Jinwoo290350/Hardware-Project/Flow-Hardware-Project.png

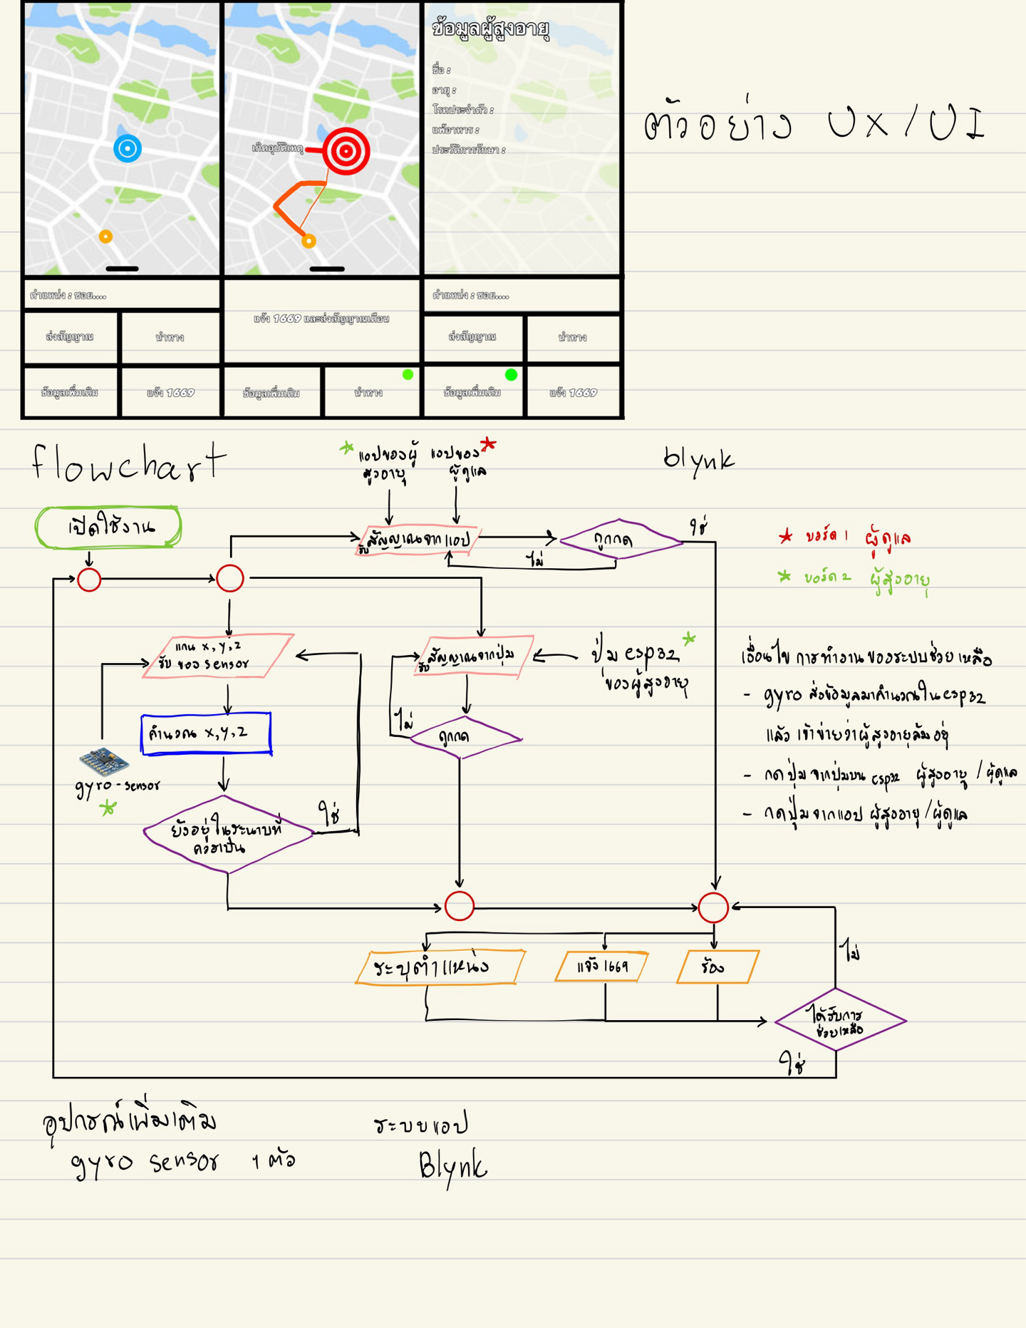
Flow-Hardware-Project.png
