Jinwoo290350/Hardware-Project/ML/models/CHEST_confusion.png

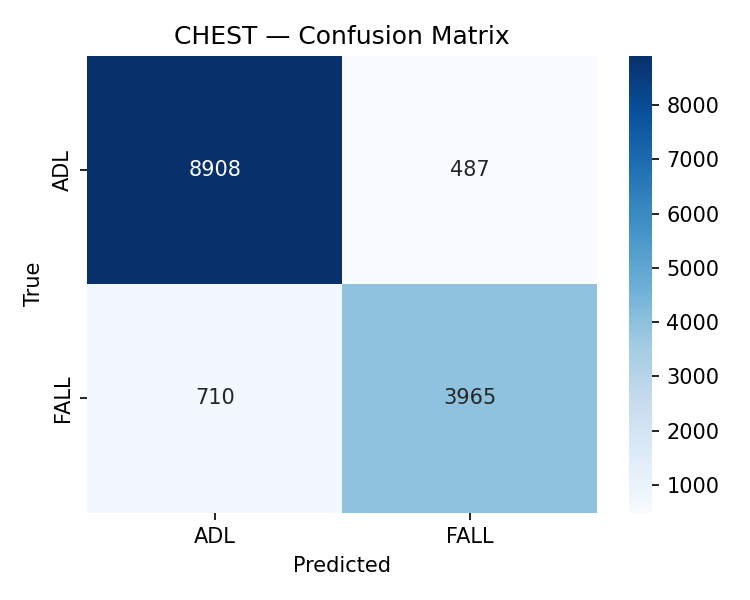
ML/models/CHEST_confusion.png
