Jinwoo290350/Hardware-Project/ML/models/CHEST_importance.png

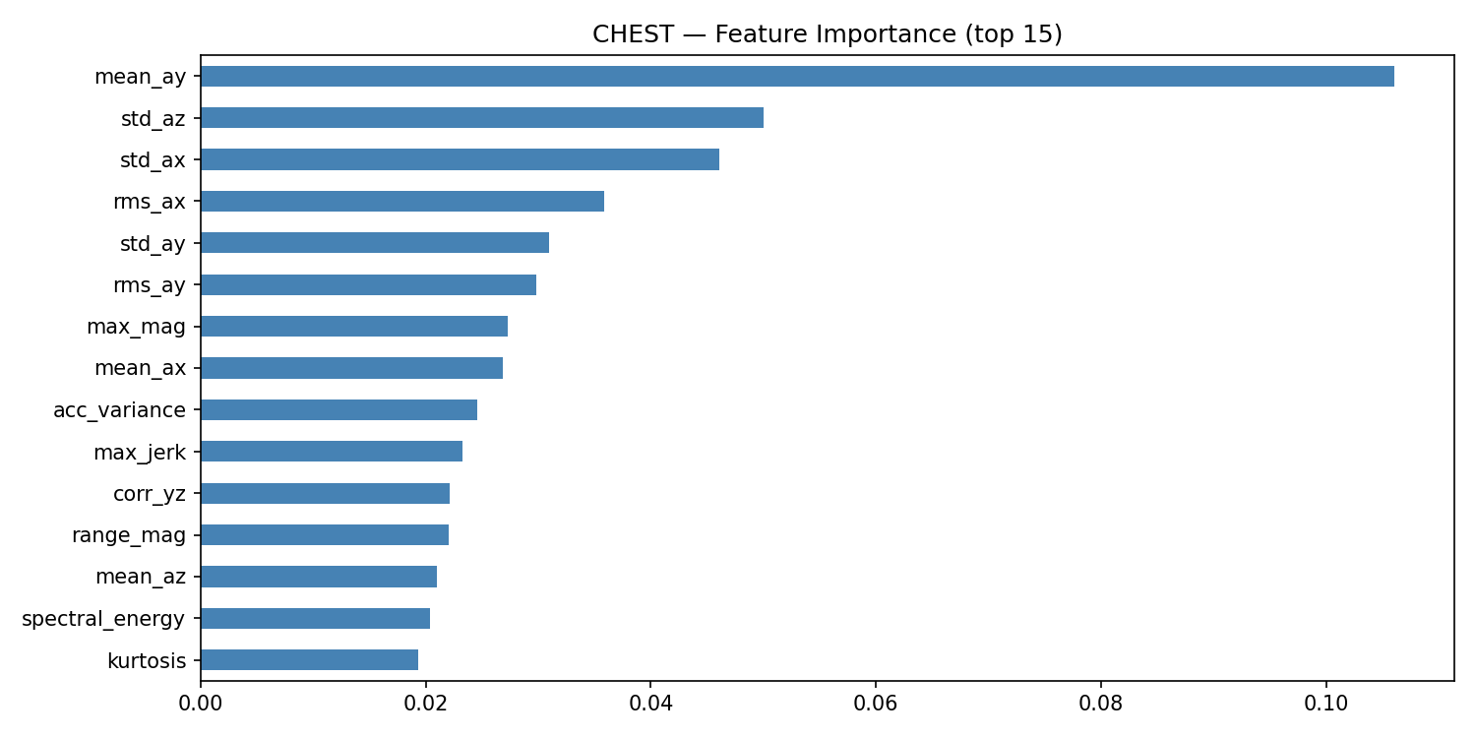
ML/models/CHEST_importance.png
