Jinwoo290350/Hardware-Project/ML/models/CHEST_signal.png

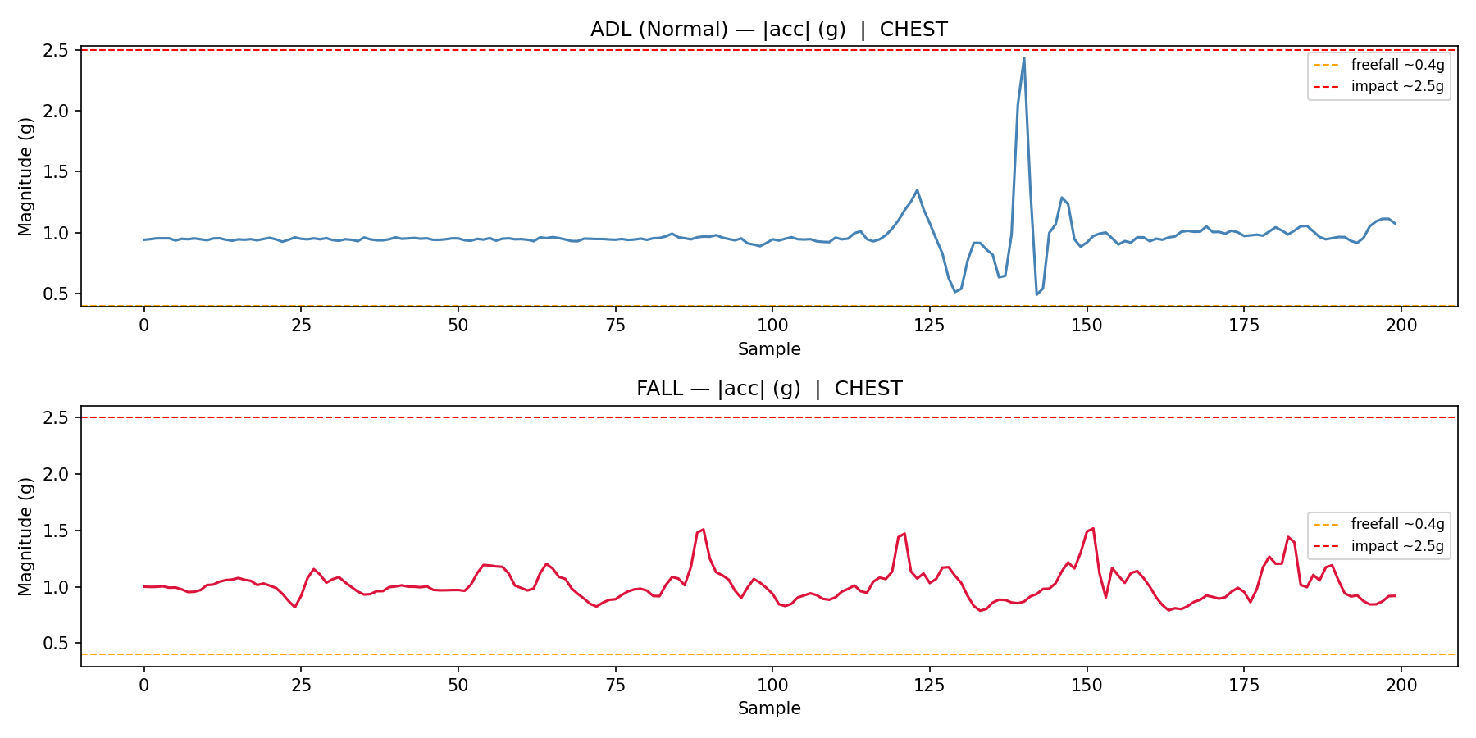
ML/models/CHEST_signal.png
