Jinwoo290350/Hardware-Project/ML/models/eval_comparison.png

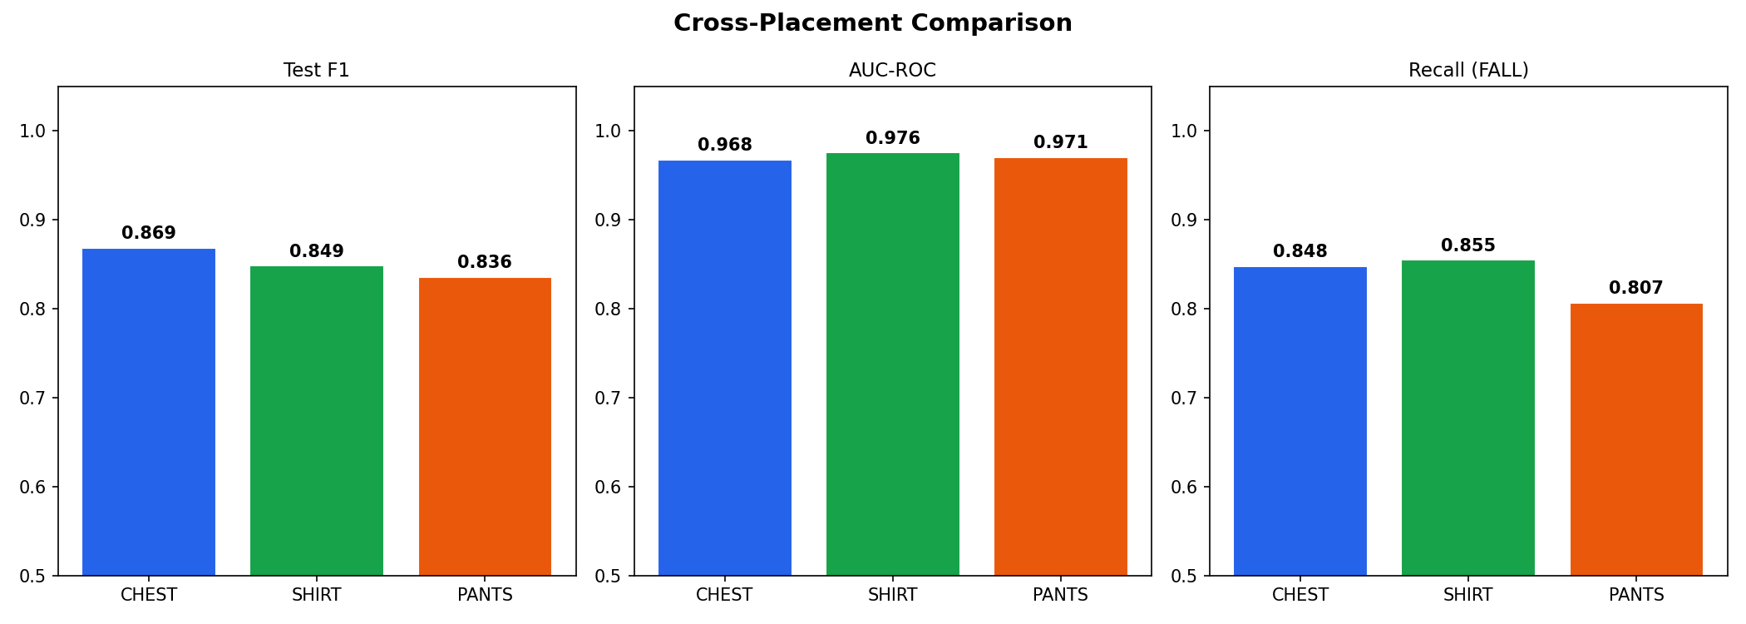
ML/models/eval_comparison.png
