Jinwoo290350/Hardware-Project/ML/models/eval_confusion.png

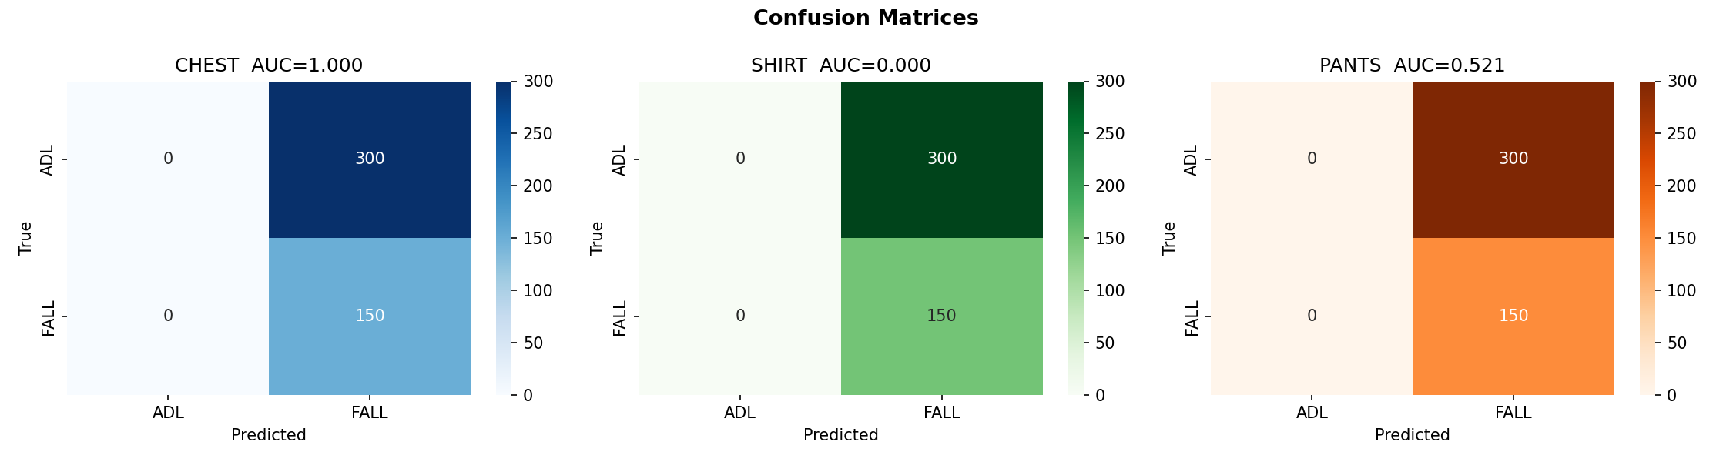
ML/models/eval_confusion.png
