Jinwoo290350/Hardware-Project/ML/models/eval_roc.png

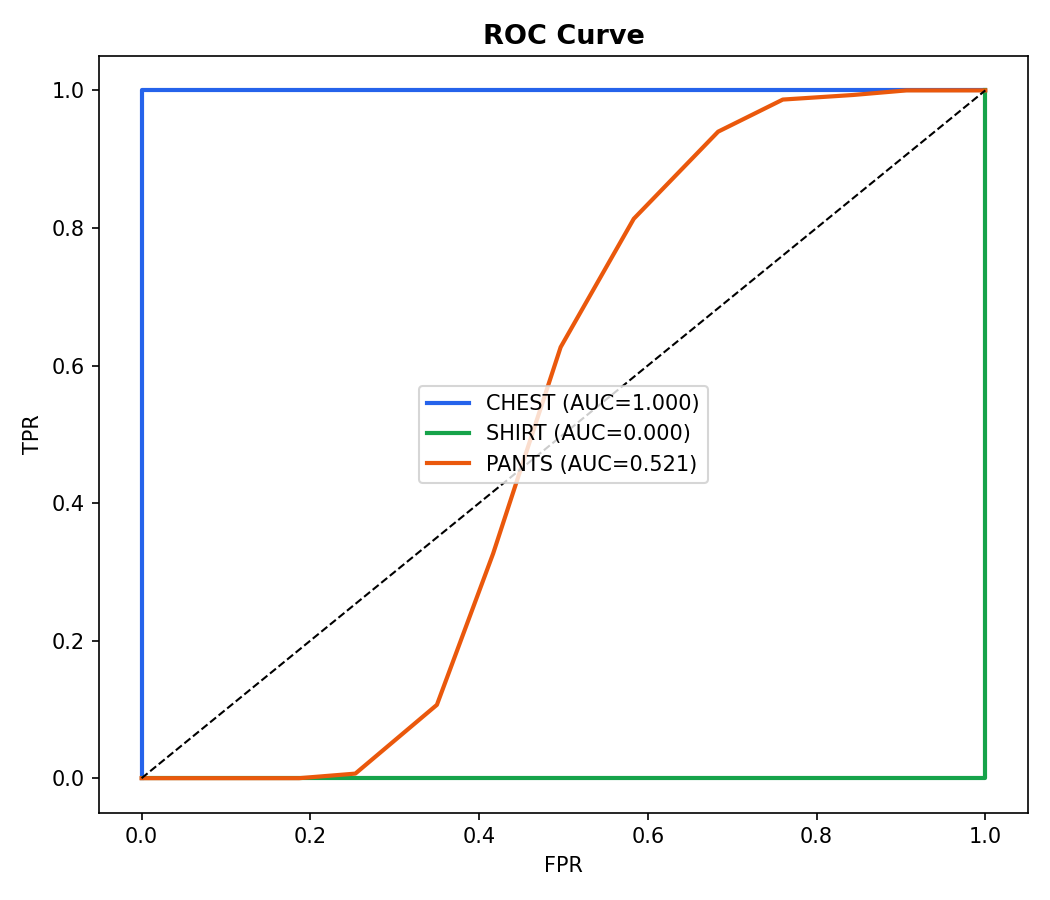
ML/models/eval_roc.png
