Jinwoo290350/Hardware-Project/ML/models/PANTS_confusion.png

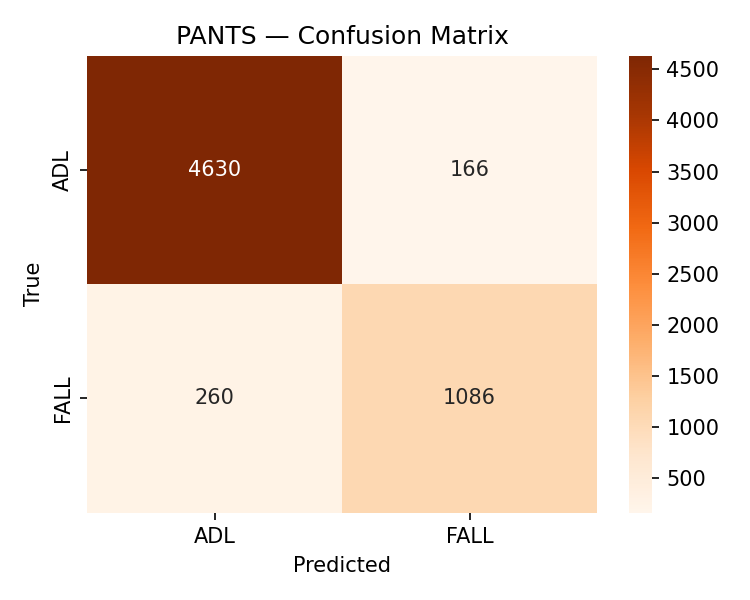
ML/models/PANTS_confusion.png
