Jinwoo290350/Hardware-Project/ML/models/SHIRT_signal.png

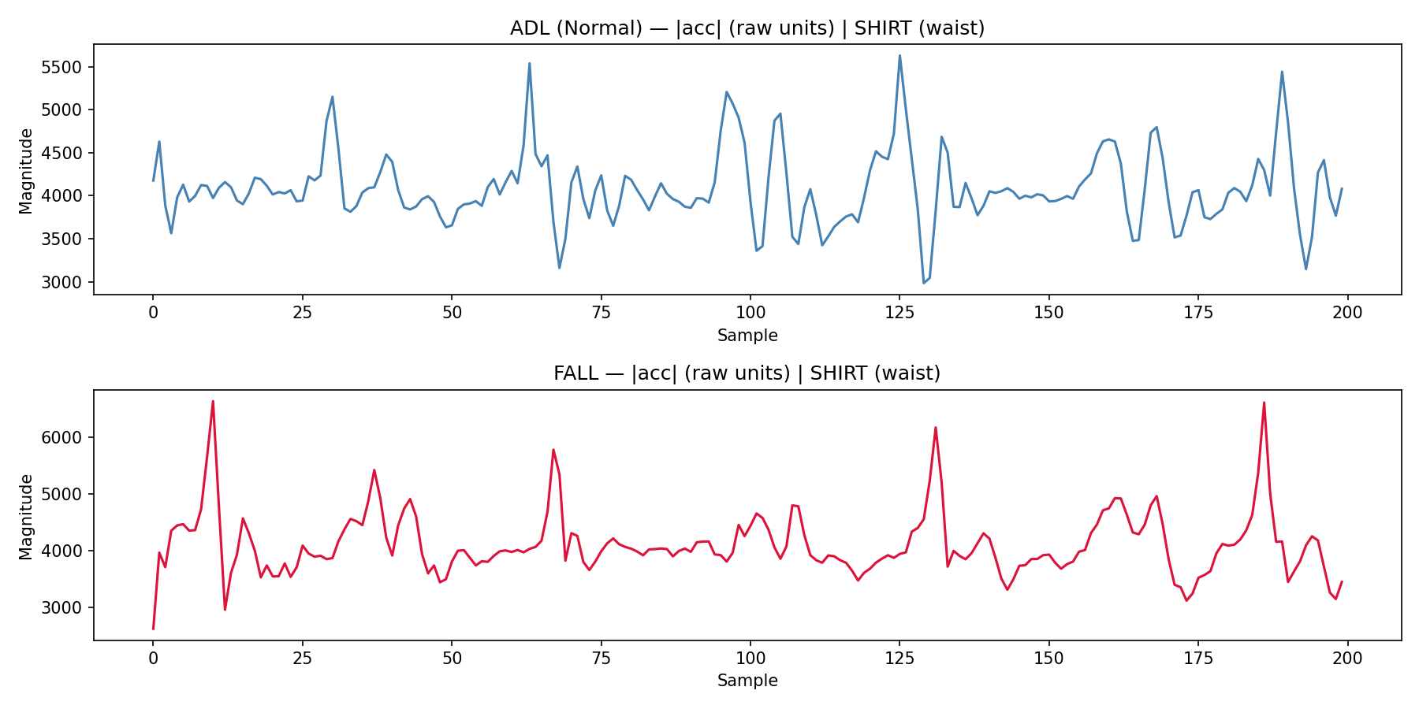
ML/models/SHIRT_signal.png
