Jinwoo290350/Hardware-Project/ML/models/CHEST_results.csv

placement | dataset | n_windows | n_features | test_f1 | precision | recall | auc | best_model
CHEST | SisFall | 70346 | 23 | 0.8688506628684124 | 0.8906109613656783 | 0.8481283422459893 | 0.9679937843829777 | ExtraTreesEntr
