Jinwoo290350/Hardware-Project/Schematic_ESP32S3_Board01.pdf

## GND

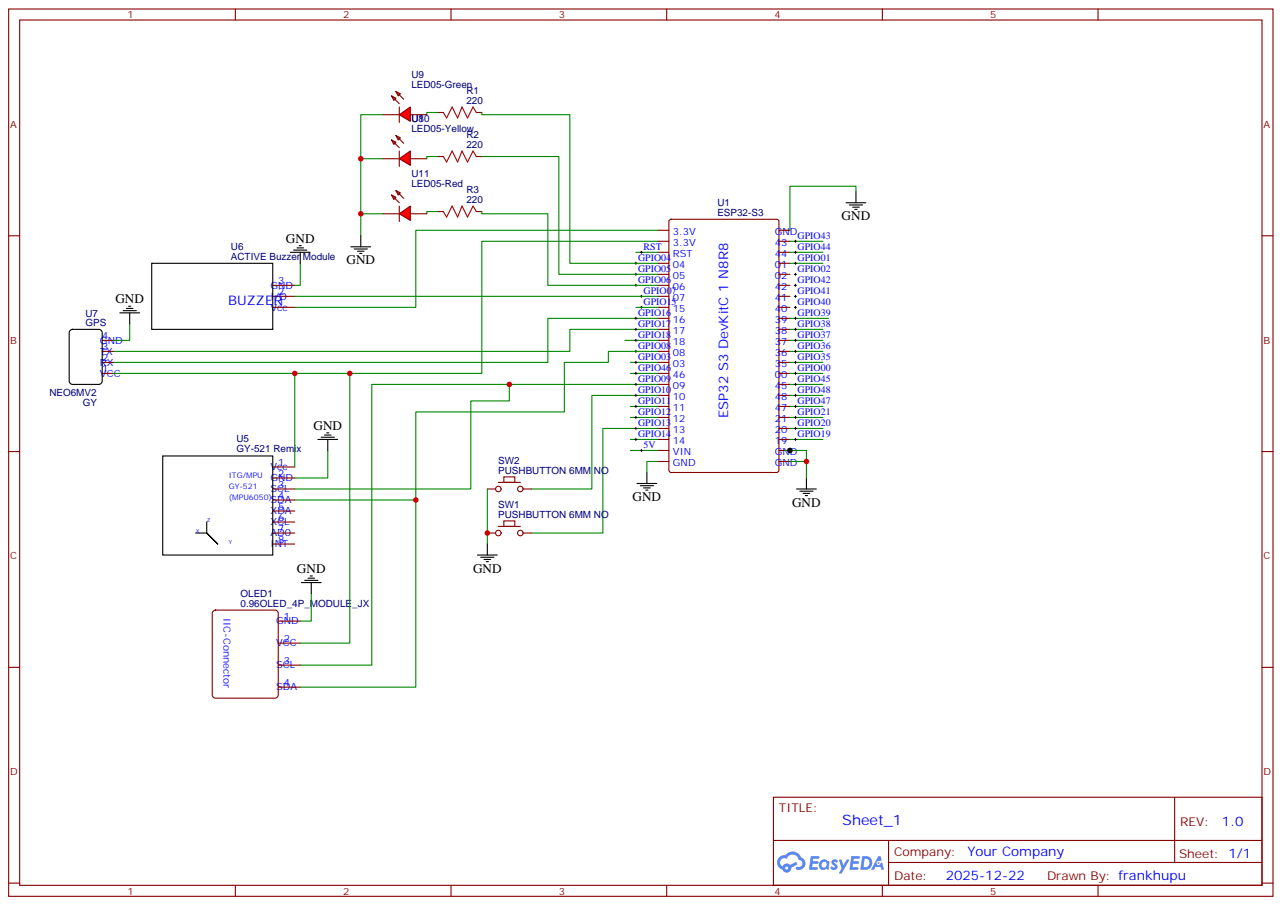
[picture p13: page 1]
