Jinwoo290350/Hardware-Project/Schematic_ESP32S3_Board02.pdf

## GND

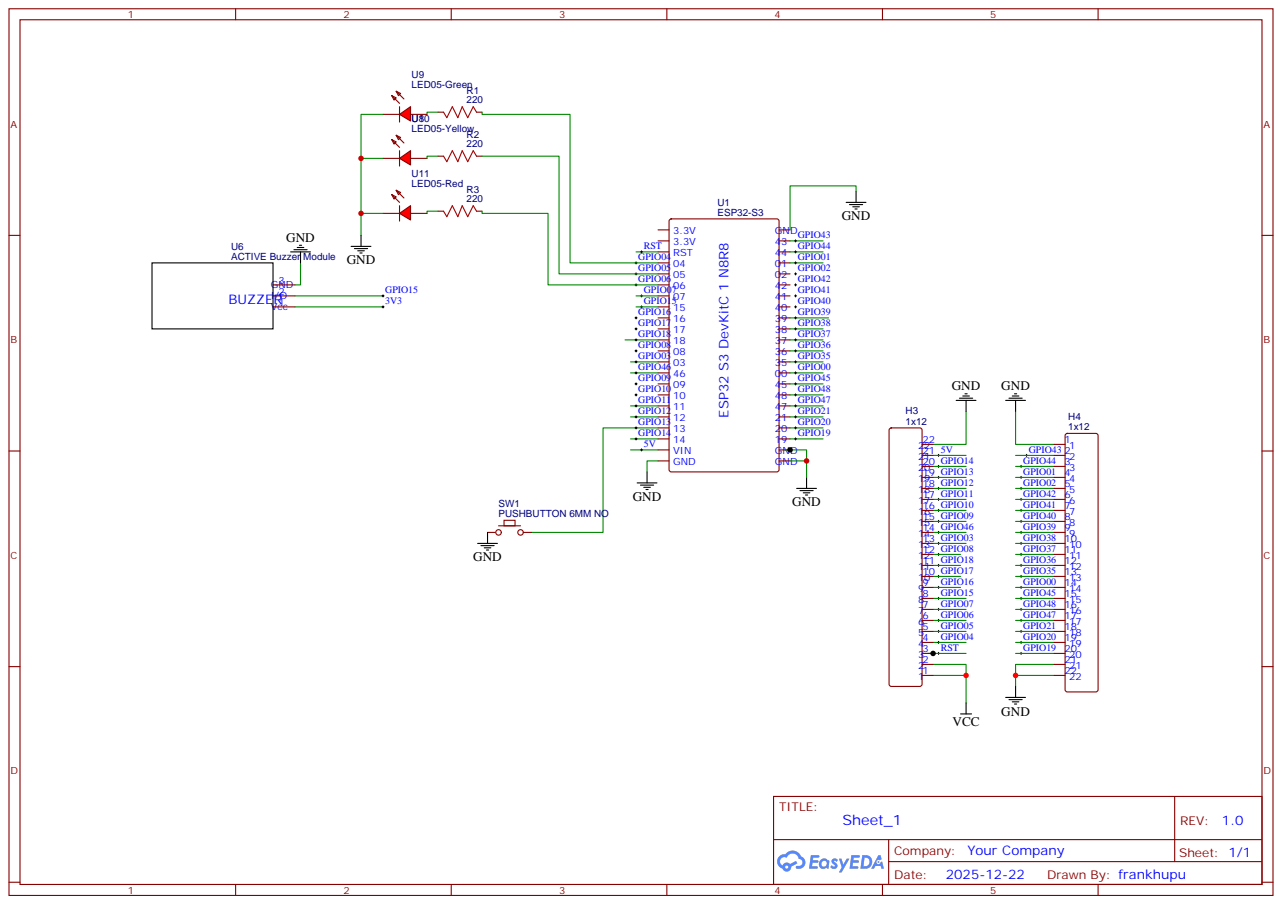
[picture p14: page 1]
