Jinwoo290350/Hardware-Project/(commit log)

2026-02-27 finish code wait automation on blynk and fix pin
    [CHEST_results.csv, PANTS_results.csv, SHIRT_results.csv, final_report.csv]
2026-03-12 docs: rewrite README with ML results, confusion matrix, feature importance
    - Add badges (License, Platform, ML, IoT)
    - Add ML results section with macro F1 scores per mode
    CHEST=0.706, SHIRT=0.683, PANTS=0.763
    - Embed realdata_overview.png, realdata_confusion.png, realdata_importance.png
    - Improve system architecture diagram and operation flow
    - Add professional formatting with div align center
2026-03-12 docs: add ESP32-S3 schematic PDFs
